Chloxeo/SCALAR-7_Experience/images/BOTTOM.png

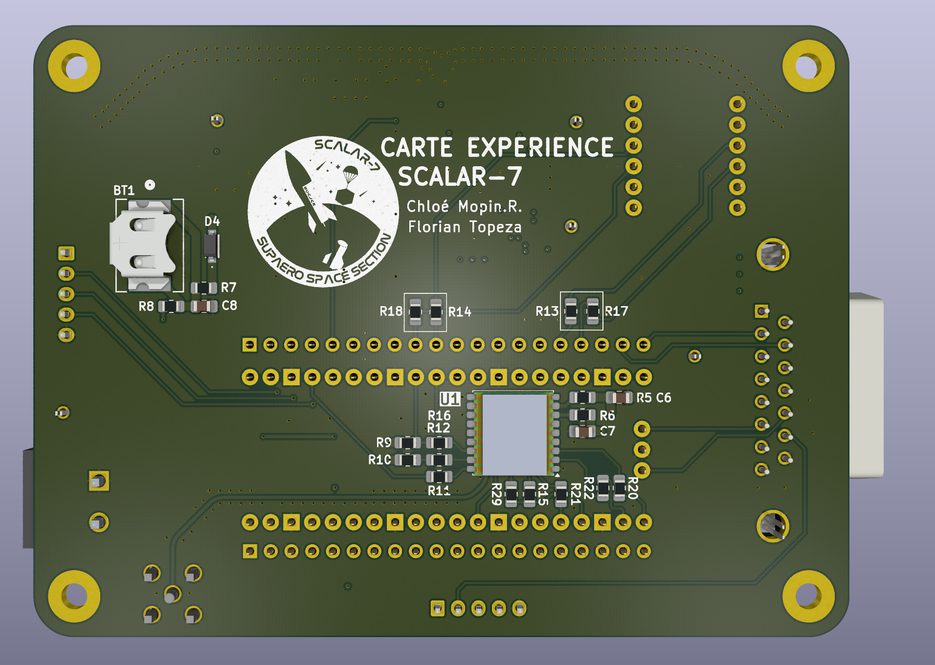
images/BOTTOM.png
