Chloxeo/SCALAR-7_Experience/images/FRONT.png

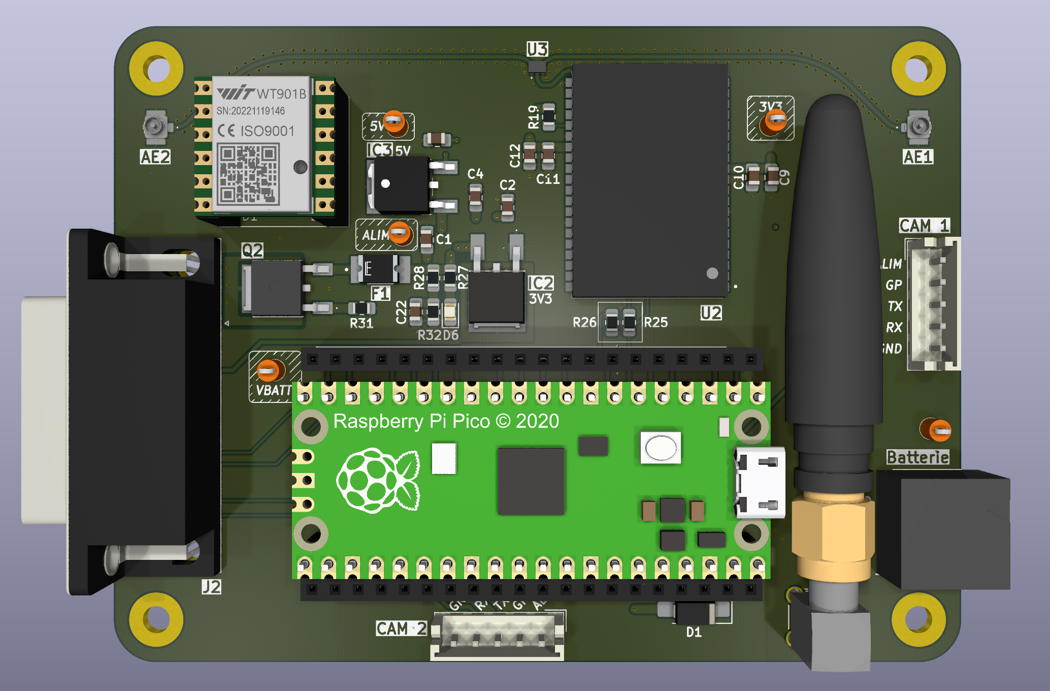
images/FRONT.png
