Chloxeo/SCALAR-7_Experience/Schematic.pdf

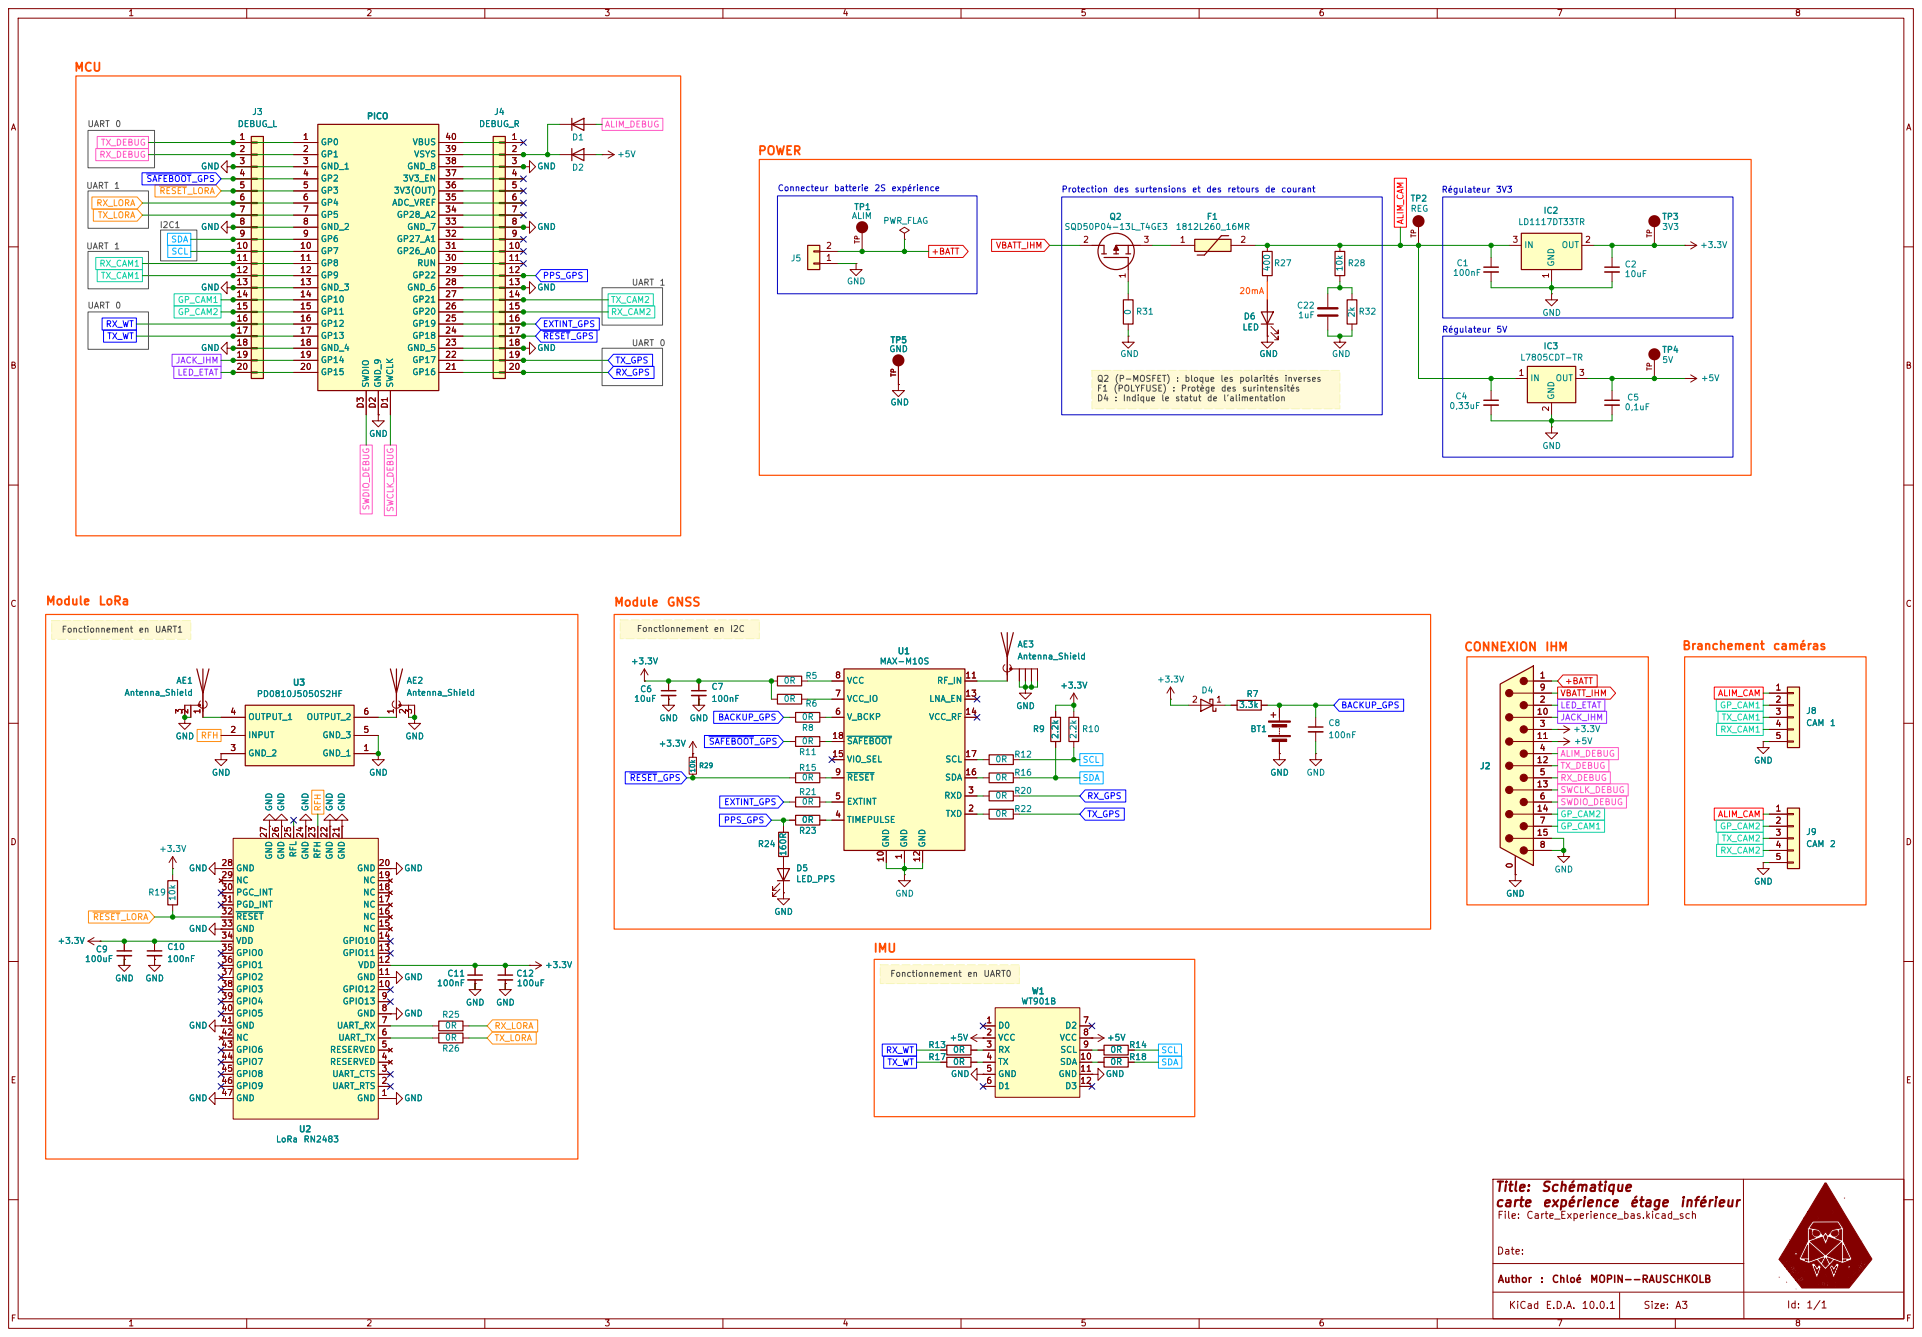
[picture p4: page 1]

2 2
3 3

TX_WT RX_CAM1 | 12 12 13 13

Q2 (P-MOSFET) : bloque les polarités inverses F1 (POLYFUSE) : Protège des surintensités D4 : Indique le statut de l'alimentation

Title: Schématique
carte expérience étage inférieur
File: Carte_Experience_bas.kicad_sch

Author : Chloé MOPIN--RAUSCHKOLB
