Chloxeo/SCALAR-7_Experience/hardware/Carte_Experience_bas.kicad_pcb

## KiCad design hardware/Carte_Experience_bas.kicad_pcb (2026-11-06)

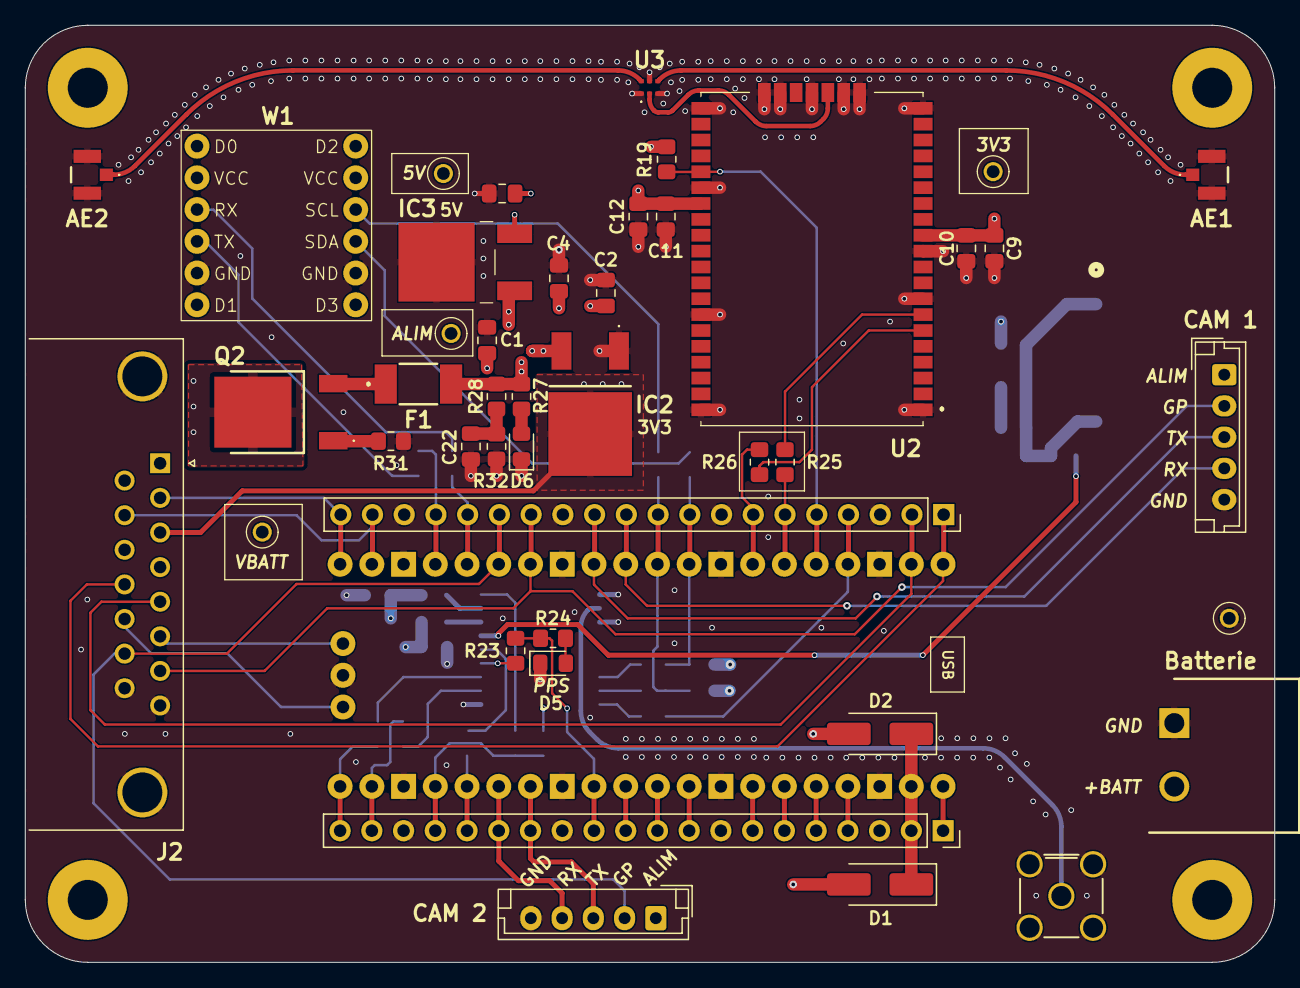
[picture p5: board Carte_Experience_bas.kicad_pcb from above]

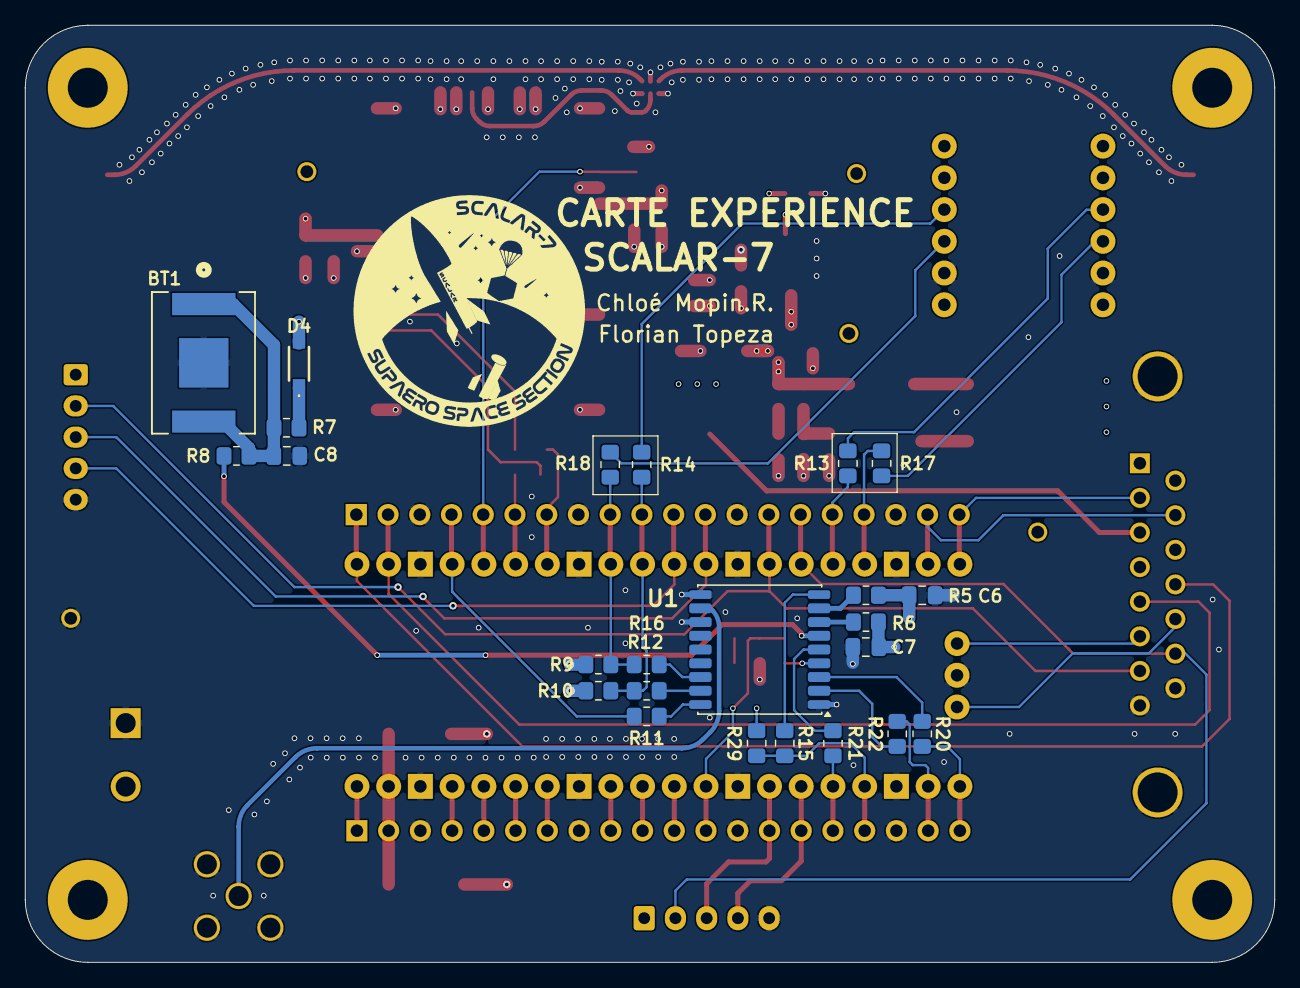
[picture p6: board Carte_Experience_bas.kicad_pcb from below]

Board: 4 copper layers, 100.0 x 75.0 mm, 72 parts (24 on the bottom side), 61 nets.

Parts:
AE1, AE2: Antenna_Shield; CONUFL001SMDT
AE3: Antenna_Shield; SMA_coude
BT1: 6.8mm 3.3V; pile btn
C1, C7, C8, C10, C11: 100nF; C_0805_2012Metric_Pad1.18x1.45mm_HandSolder
C2, C6: 10uF; C_0805_2012Metric_Pad1.18x1.45mm_HandSolder
C4: 0,33uF; C_0805_2012Metric_Pad1.18x1.45mm_HandSolder
C5: 0,1uF; C_0805_2012Metric_Pad1.18x1.45mm_HandSolder
C9, C12: 100uF; C_0805_2012Metric_Pad1.18x1.45mm_HandSolder
C22: 1uF; C_0805_2012Metric_Pad1.18x1.45mm_HandSolder
D1, D2: D; D_SMA_Handsoldering
D4: BAT54W
D5: LED_PPS; LED_0805_2012Metric_Pad1.15x1.40mm_HandSolder
D6: LED; LED_0805_2012Metric_Pad1.15x1.40mm_HandSolder
F1: 1812L260_16MR; 1812L010DR
H1, H2, H3, H4: MountingHole; MountingHole_3.2mm_M3_Pad
IC2: LD1117DT33TR
IC3: L7805CDT-TR; L7805CDTTR
J1: PICO
J2: DA15_Pins_MountingHoles; DSUB-15_Pins_Horizontal_P2.77x2.84mm_EdgePinOffset7.70mm_Ho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
J3: DEBUG_L; PinSocket_1x20_P2.54mm_Vertical
J4: DEBUG_R; PinSocket_1x20_P2.54mm_Vertical
J5: Batterie; OQ0254510000G
J8: CAM 1; JST_EH_B5B-EH-A_1x05_P2.50mm_Vertical
J9: CAM 2; JST_EH_B5B-EH-A_1x05_P2.50mm_Vertical
Q2: SQD50P04-13L_T4GE3; Q2 SQD50P0413L_T4GE3
R5, R6, R8, R11, R12, R13, R14, R15, R16, R17, R18, R20, R21, R22, R23, R25, R26: 0R; R_0805_2012Metric_Pad1.20x1.40mm_HandSolder
R7: 3.3k; R_0805_2012Metric_Pad1.20x1.40mm_HandSolder
R9, R10: 2.2k; R_0805_2012Metric_Pad1.20x1.40mm_HandSolder
R19, R28, R29: 10k; R_0805_2012Metric_Pad1.20x1.40mm_HandSolder
R24: 160R; R_0805_2012Metric_Pad1.20x1.40mm_HandSolder
R27: 400; R_0805_2012Metric_Pad1.20x1.40mm_HandSolder
R31: 0; R_0805_2012Metric_Pad1.20x1.40mm_HandSolder
R32: 2k; R_0805_2012Metric_Pad1.20x1.40mm_HandSolder
TP1: ALIM; 5003
TP2: REG; 5003
TP3: 3V3; 5003
TP4: 5V; 5003
TP5: GND; 5003
U1: MAX-M10S; ublox_MAX
U2: LoRa RN2483; RN2483AIRM104
U3: PD0810J5050S2HF
W1: WT901B; TestPoint_Pad_1.0x1.0mm

Connections:
+3.3V: C2.1, C6.1, C7.1, C9.1, C10.1, C11.1, C12.1, D4.2 (A), IC2.2 (OUT), J2.3, R5.1, R6.1, R9.1, R10.1, R19.1, R29.1, TP3.TP, U2.12 (VDD), U2.34 (VDD)
+5V: C5.1, D2.2 (A), IC3.3 (OUT), J2.11 (P111), TP4.TP, W1.2 (VCC), W1.8 (VCC)
+BATT: J2.1, J5.2, TP1.TP
ALIM_CAM: C1.1, C4.1, F1.2, IC2.3 (IN), IC3.1 (IN), J8.1, J9.1, R27.1, R28.1, TP2.TP
ALIM_DEBUG: D1.2 (A), J2.4
BACKUP_GPS: BT1.1 (+), C8.1, R7.2, R8.1
EXTINT_GPS: J1.25 (GP19), J4.16, R21.1
GND: AE1.2 (GND), AE1.3 (GND), AE2.2 (GND), AE2.3 (GND), AE3.2 (GND), AE3.3 (GND), AE3.4 (GND), AE3.5 (GND), BT1.2 (-), C1.2, C2.2, C4.2, C5.2, C6.2, C7.2, C8.2, C9.2, C10.2, C11.2, C12.2, C22.2, D5.1 (K), D6.1 (K), IC2.1 (GND), IC3.2 (GND), J1.3 (GND_1), J1.8 (GND_2), J1.13 (GND_3), J1.18 (GND_4), J1.23 (GND_5), J1.28 (GND_6), J1.33 (GND_7), J1.38 (GND_8), J1.D2 (GND_9), J2.0 (PAD), J2.8, J2.15, J3.3, J3.8, J3.13, J3.18, J4.3, J4.8, J4.13, J4.18, J5.1, J8.5, J9.5, R31.2, R32.2, TP5.TP, U1.1 (GND), U1.10 (GND), U1.12 (GND), U2.1 (GND), U2.8 (GND), U2.11 (GND), U2.20 (GND), U2.21 (GND), U2.22 (GND), U2.24 (GND), U2.26 (GND), U2.27 (GND), U2.28 (GND), U2.33 (GND), U2.41 (GND), U2.47 (GND), U3.1 (GND_1), U3.3 (GND_2), U3.5 (GND_3), W1.5 (GND), W1.11 (GND)
GP_CAM1: J1.14 (GP10), J2.7, J3.14, J8.2
GP_CAM2: J1.15 (GP11), J2.14, J3.15, J9.2
JACK_IHM: J1.19 (GP14), J2.10, J3.19
LED_ETAT: J1.20 (GP15), J2.2, J3.20
unnamed: AE1.1 (A), U3.4 (OUTPUT_1)
unnamed: AE2.1 (A), U3.6 (OUTPUT_2)
unnamed: AE3.1 (A), U1.11 (RF_IN)
unnamed: C22.1, R28.2, R32.1
unnamed: D1.1 (K), D2.1 (K), J1.39 (VSYS), J4.2
unnamed: D4.1 (K), R7.1
unnamed: D5.2 (A), R24.1
unnamed: D6.2 (A), R27.2
unnamed: Q2.1 (G), R31.1
unnamed: F1.1, Q2.3 (S)
unnamed: R21.2, U1.5 (EXTINT)
unnamed: R20.2, U1.3 (RXD)
unnamed: R12.2, U1.17 (SCL)
unnamed: R16.2, U1.16 (SDA)
unnamed: R23.2, U1.4 (TIMEPULSE)
unnamed: R22.2, U1.2 (TXD)
unnamed: R5.2, U1.8 (VCC)
unnamed: R6.2, U1.7 (VCC_IO)
unnamed: R8.2, U1.6 (V_BCKP)
unnamed: R15.2, U1.9 (~RESET)
unnamed: R11.2, U1.18 (~SAFEBOOT)
unnamed: R25.2, U2.7 (UART_RX)
unnamed: R26.2, U2.6 (UART_TX)
unnamed: R13.2, W1.3 (RX)
unnamed: R14.2, W1.9 (SCL)
unnamed: R18.2, W1.10 (SDA)
unnamed: R17.2, W1.4 (TX)
PPS_GPS: J1.29 (GP22), J4.12, R23.1, R24.2
RFH: U2.23 (RFH), U3.2 (INPUT)
RX_CAM1: J1.11 (GP8), J3.11, J8.4
RX_CAM2: J1.26 (GP20), J4.15, J9.4
RX_DEBUG: J1.2 (GP1), J2.5, J3.2
RX_GPS: J1.21 (GP16), J4.20, R20.1
RX_LORA: J1.6 (GP4), J3.6, R25.1
RX_WT: J1.16 (GP12), J3.16, R13.1
SCL: J1.10 (GP7), J3.10, R10.2, R12.1, R14.1
SDA: J1.9 (GP6), J3.9, R9.2, R16.1, R18.1
SWCLK_DEBUG: J1.D1 (SWCLK), J2.13
SWDIO_DEBUG: J1.D3 (SWDIO), J2.6
TX_CAM1: J1.12 (GP9), J3.12, J8.3
TX_CAM2: J1.27 (GP21), J4.14, J9.3
TX_DEBUG: J1.1 (GP0), J2.12, J3.1
TX_GPS: J1.22 (GP17), J4.19, R22.1
TX_LORA: J1.7 (GP5), J3.7, R26.1
TX_WT: J1.17 (GP13), J3.17, R17.1
VBATT_IHM: J2.9, Q2.2 (D)
~RESET_GPS: J1.24 (GP18), J4.17, R15.1, R29.2
~RESET_LORA: J1.5 (GP3), J3.5, R19.2, U2.32 (~RESET)
~SAFEBOOT_GPS: J1.4 (GP2), J3.4, R11.1
